tytuswota/project2_robot/src/In te leveren/Designs/Elektrisch-Breadbord - CarierBot.png

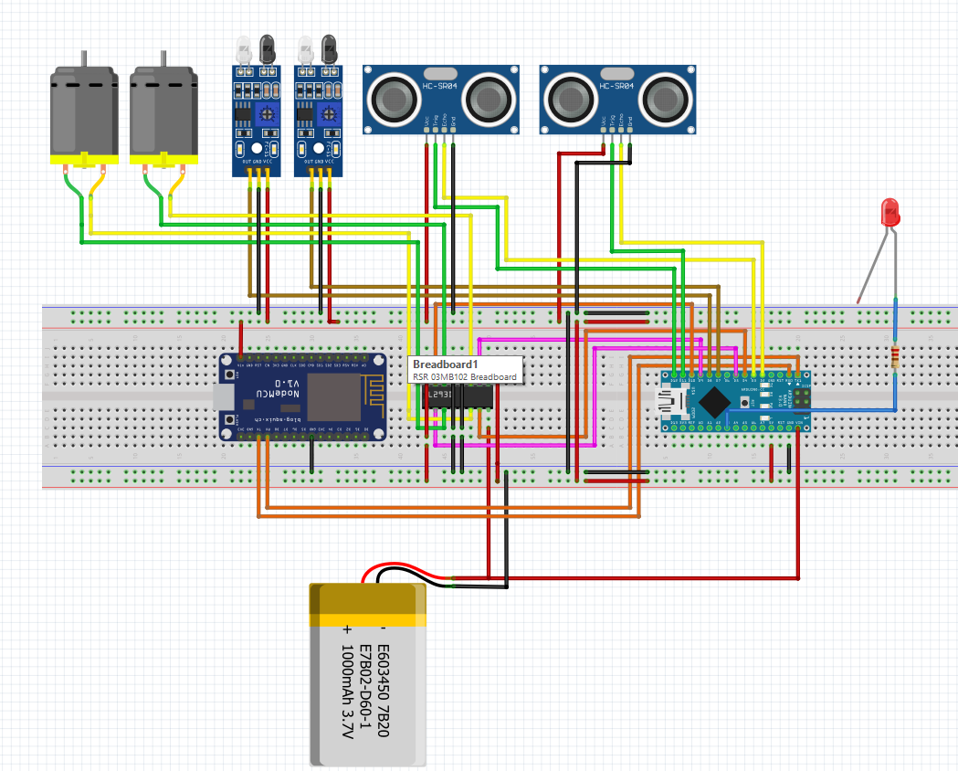
src/In te leveren/Designs/Elektrisch-Breadbord - CarierBot.png
