tytuswota/project2_robot/src/In te leveren/Samenwerkingsdocument.docx

# Communicatie:

Trello: https://trello.com/invite/b/eTOd7nyf/eec76396aa9148cb26cf514e199dbecb/project-2-rescue-bot

Git.

Drive.

Whatsapp.

# Tijden:

Maandag: 13:00 tot 17:00 4 uur

Dinsdag: 13:50 tot 17:00 3 uur

Woensdag: 15:50 tot 18:40 3 uur

Donderdag: projectles

Vrijdag: vrij

# Afspraken

## General afspraken:

- Kom op tijd
- Als iets dwars zit spreek het uit
- Laat elkaar uitpraten
- Kom 3 keer te laat en koop taart
- Niet te lang blijven hangen bij iets als het niet lukt, vraag het aan een ander

## Code afspraken:

- OOP (Classes gebruiken)
- Comment je code
- camelCase
- Laat je code door iemand testen voor push

## File sharing:

- Licht alles toe
- Gebruik github
- Zet .docx bestanden op Google Drive.
- Test eerst voordat je upload.

## Debugging:

- Don’s debugging ‘tool’
- Debug je eigen werk eerst
