tytuswota/project2_robot/src/In te leveren/Designs/Elektrisch-Breadbord.png

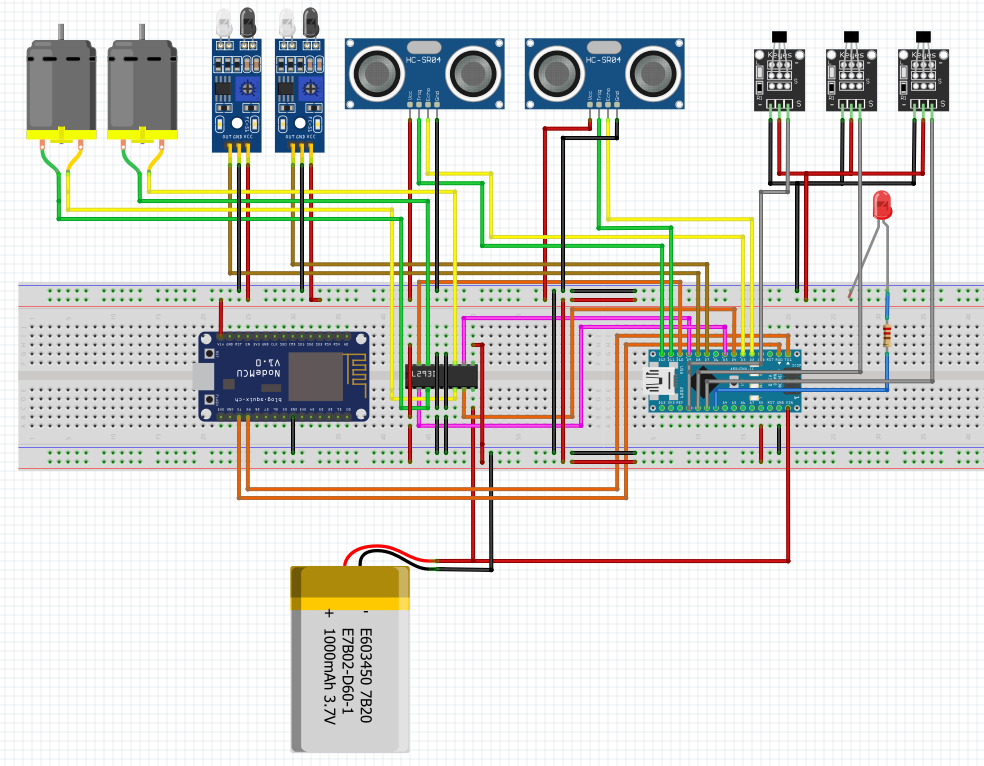
src/In te leveren/Designs/Elektrisch-Breadbord.png
