tytuswota/project2_robot/src/In te leveren/Designs/Elektrisch-Schema - CarierBot.png

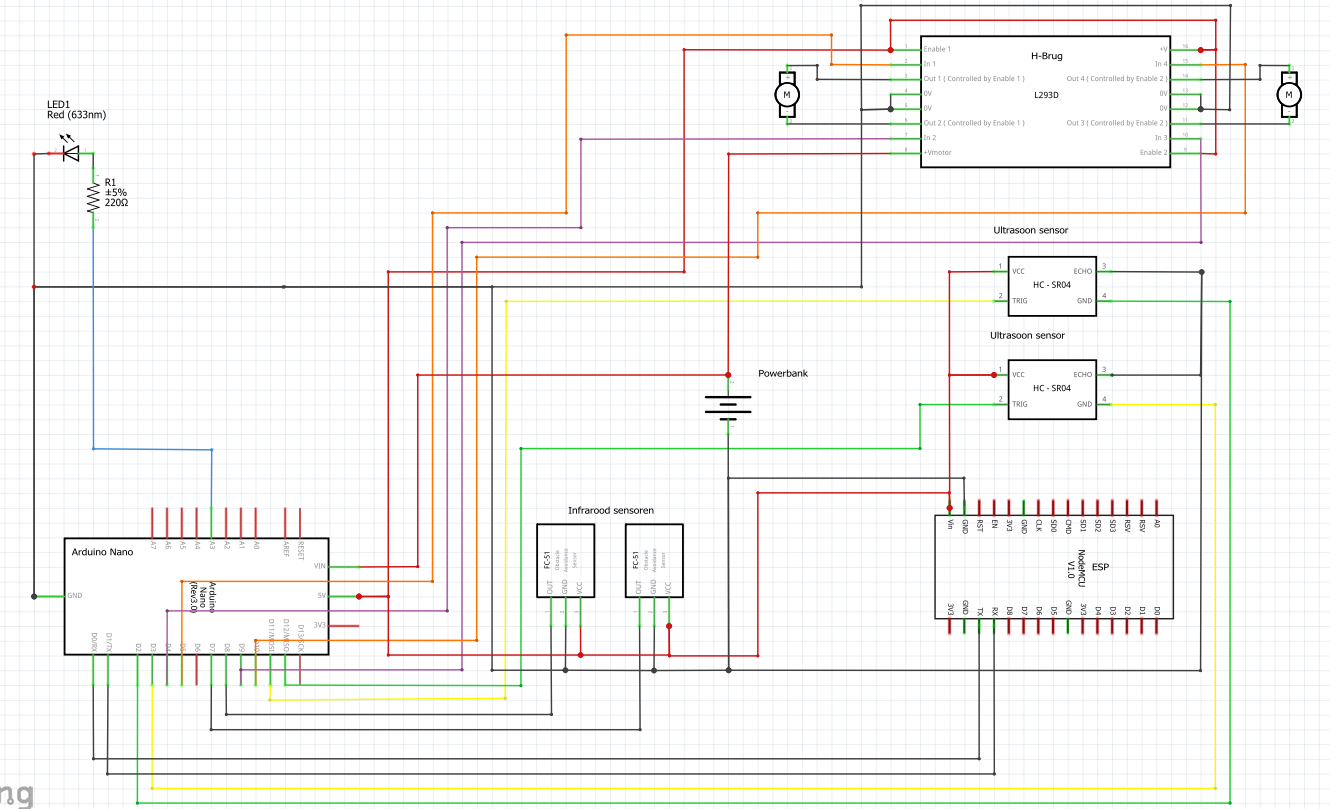
src/In te leveren/Designs/Elektrisch-Schema - CarierBot.png
