tytuswota/project2_robot/src/In te leveren/Designs/Elektrisch-Schema.png

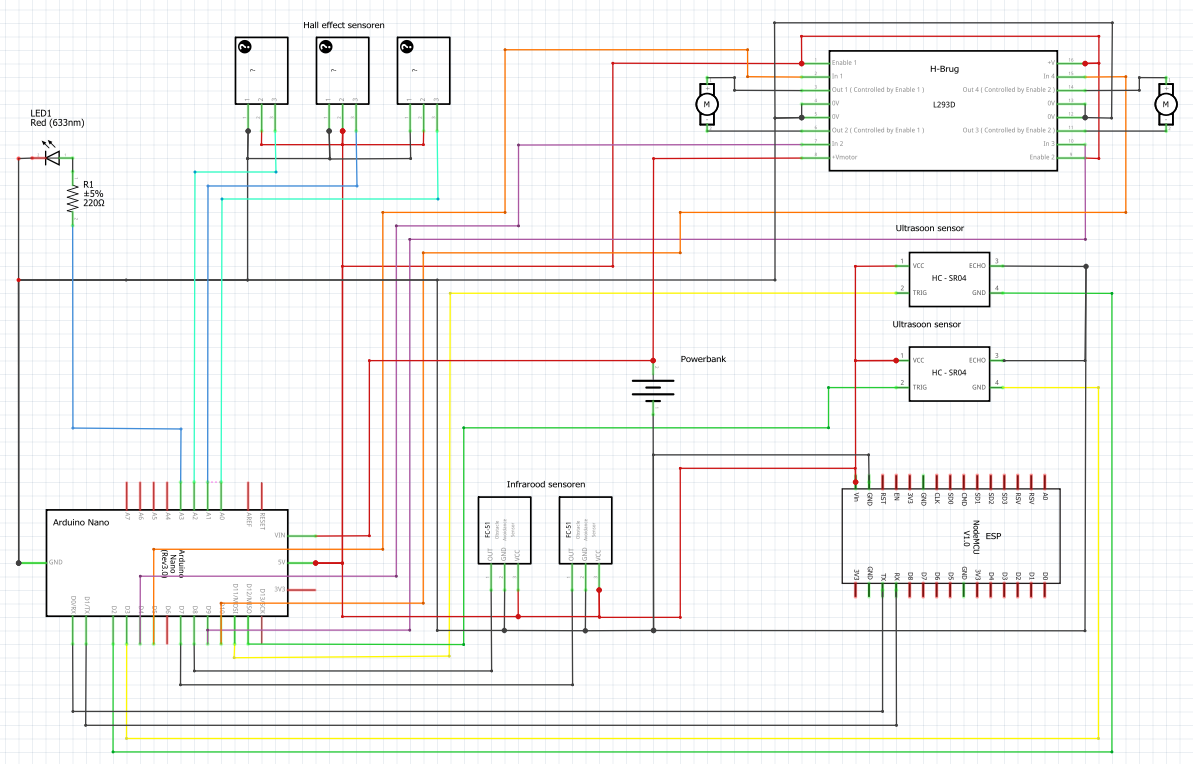
src/In te leveren/Designs/Elektrisch-Schema.png
