tytuswota/project2_robot/src/In te leveren/Designs/CarierBot.stl

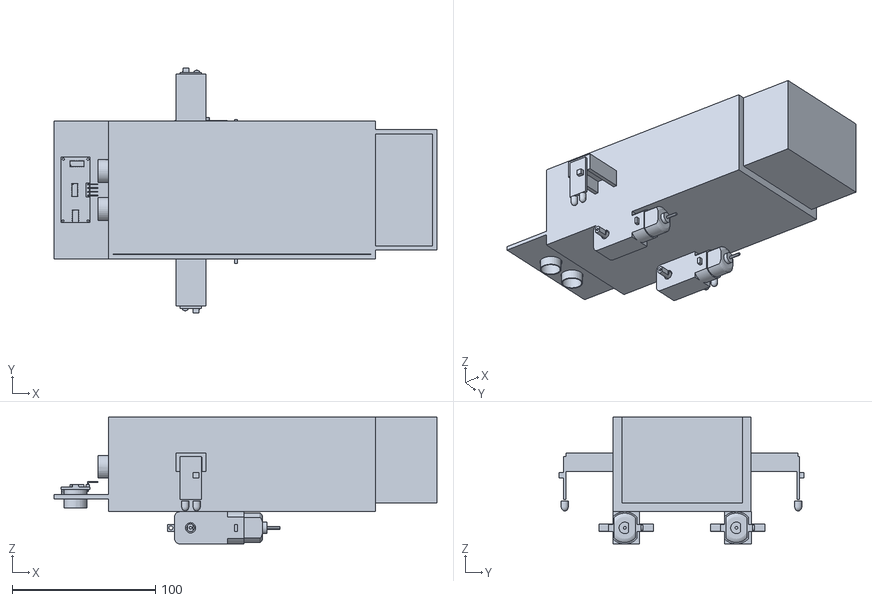
[picture p5: CAD file, 2020-01-24]
src/In te leveren/Designs/CarierBot.stl
267.0 x 170.8 x 88.5
