tytuswota/project2_robot/src/In te leveren/Designs/ScoutBot.stl

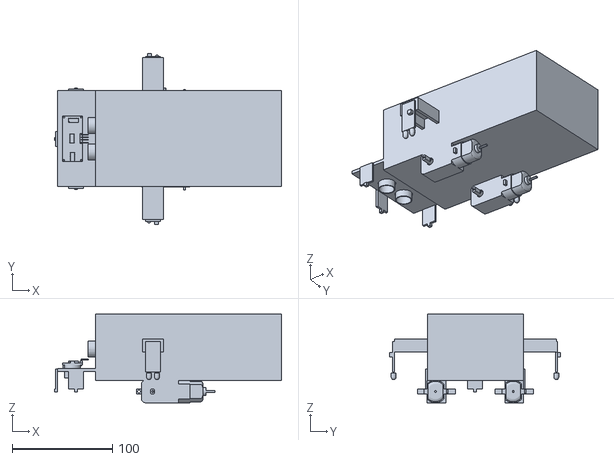
[picture p6: CAD file, 2020-01-24]
src/In te leveren/Designs/ScoutBot.stl
227.0 x 170.8 x 88.5
