tytuswota/project2_robot/src/motorController/motorController.ino

#define motorPin1A 3
#define motorPin1B 2
#define motorPin2A 5
#define motorPin2B 4

void setup() {
  pinMode(motorPin1A, OUTPUT);
  pinMode(motorPin1B, OUTPUT);
  pinMode(motorPin2A, OUTPUT);
  pinMode(motorPin2B, OUTPUT);
}

void loop() {
  motorSpinABackward();
  motorSpinBForward();
}

void motorSpinAForward() {
  digitalWrite(motorPin1A, HIGH);
  digitalWrite(motorPin1B, LOW);
}
void motorSpinBForward() {
  digitalWrite(motorPin2A, HIGH);
  digitalWrite(motorPin2B, LOW);
}
void motorSpinABackward() {
  digitalWrite(motorPin1A, LOW);
  digitalWrite(motorPin1B, HIGH);
}
void motorSpinBBackward() {
  digitalWrite(motorPin2A, LOW);
  digitalWrite(motorPin2B, HIGH);
}

void motorAStop() {
  digitalWrite(motorPin1A, LOW);
  digitalWrite(motorPin1B, LOW);
}
void motorBStop() {
  digitalWrite(motorPin2A, LOW);
  digitalWrite(motorPin2B, LOW);
}
