tytuswota/project2_robot/(commit log)

2019-11-27 Charlie kan nog steeds niet solderen
2019-12-09 Motor Controller File Added
2019-12-09 added code for ultrasonic sensor
2019-12-10 no longer needs to call pulse in loop
    [UltrasonicSensor.cpp, ultrasonic.ino]
2019-12-11 Infrarood met motor controller
2019-12-16 now uses both sensors
2020-01-06 New motorController functions
2020-01-06 Motor controller fixes
2020-01-06 fully rewrote ultrasonic sensor code
2020-01-06 fixed ultrasonic sensors
2020-01-16 Hall effect
2020-01-16 IR Changes + motors turned around
2020-01-20 de esp
2020-01-22 hall sensor code
2020-01-24 3D models added
    [CarierBot.stl, ScoutBot.stl]
2020-01-24 Added map with finished products
    [CarierBot.stl, ScoutBot.stl]
